carTloyal123/lochness/hardware/bom/devkit.csv

Category | Qty | Part | Manufacturer | MPN | Supplier | Supplier SKU | Unit USD | Extended USD | Required | In model | Price confirmed | URL | Notes
Bought | 1 | Espressif ESP32-C6-DevKitM-1 (the product's ESP32-C6-MINI-1 module), on its pin headers | Espressif | ESP32-C6-DEVKITM-1-N4 | DigiKey | 1965-ESP32-C6-DEVKITM-1-N4-ND | 8.00 | 8.00 | yes | yes | yes | https://www.digikey.com/en/products/detail/espressif-systems/ESP32-C6-DEVKITM-1-N4/18667011 | Headers appear fitted in photos; the user guide doesn't say.
Bought | 2 | Mini breadboard, 170 points (47 x 35 mm), adhesive back | SparkFun | PRT-12043 | SparkFun | PRT-12043 | 5.25 | 10.50 | yes | yes | yes | https://www.sparkfun.com/products/12043
Bought | 1 | NdFeB magnet 3 x 2 mm, axial (bolt position) | Apex Magnets | M3x2MMDI | Apex Magnets | M3x2MMDI | 0.18 | 0.18 | yes | yes | yes | https://www.apexmagnets.com/3mm-x-2mm-disc-neodymium-magnet | N48. Pack of 50 for $8.99.
Bought | 1 | Pololu #2130 DRV8833 dual motor driver carrier, on 2x 1x8 pin headers | Pololu | 2130 | Pololu | 2130 | 10.95 | 10.95 | yes | yes | yes | https://www.pololu.com/product/2130 | Headers included, unsoldered.
Bought | 1 | Pololu #5193 gearmotor, 150:1 HPCB 6 V, 12 CPR encoder, side connector (6-pin JST SH cable) | Pololu | 5193 | Pololu | 5193 | 32.45 | 32.45 | yes | yes | yes | https://www.pololu.com/product/5193 | Cable not included. $29.85 each at 5+.
Bought | 3 | SparkFun BOB-00717 SOT-23 adapter with a DRV5032FADBZR and 2x 1x3 header, worn chip-down | SparkFun | BOB-00717 | SparkFun | BOB-00717 | 1.25 | 3.75 | yes | yes | yes | https://www.sparkfun.com/products/717 | Adapter only: the chip and headers are separate lines. Page says 8.6 x 11.7 mm.
Bought | 3 | DRV5032FADBZR Hall switch, SOT-23 (soldered to the adapters) | Texas Instruments | DRV5032FADBZR | DigiKey | 296-47765-1-ND | 0.33 | 0.99 | yes | no | yes | https://www.digikey.com/en/products/detail/texas-instruments/DRV5032FADBZR/7400094
Bought | 1 | Break-away male headers, 40-pin, 0.1" (2x 1x3 per adapter) | SparkFun | PRT-00116 | SparkFun | PRT-00116 | 1.95 | 1.95 | yes | no | yes | https://www.sparkfun.com/products/116
Bought | 1 | Motor cable, 6-pin JST SH-style to bare wires, 12 cm (tinned ends into the breadboard) | Pololu | 4762 | Pololu | 4762 | 2.10 | 2.10 | yes | no | yes | https://www.pololu.com/product/4762 | Or a #4765 cable and a #4772 breakout ($1.49) for 0.1" pins.
Bought | 1 | Door-frame magnet for the door-position switch, NdFeB disc about 10 x 3 mm, axial, adhesive-backed | Apex Magnets |  | Apex Magnets |  | 0.50 | 0.50 | yes | no | estimate |  | Not chosen yet: size it for the door gap against the DRV5032FA's 3.9 mT. Price estimated.
Bought | 1 | USB-C cable, data (powers and programs the DevKit) | any |  |  |  | 5.00 | 5.00 | yes | no | estimate |  | Price estimated.
Cell | 4 | AA 1.5 V lithium cell (Energizer L91) | Energizer | L91 | Ace Hardware | L91SBP-8 | 3.37 | 13.48 | yes | yes | estimate |  | 8-pack about $27; US range $19-40.
Metal | 1 | Back plate, 3 mm steel, laser cut, 2x M3 tapped | SendCutSend | custom (0.119" mild steel, 2x M3 tap) | SendCutSend |  | 14.00 | 14.00 | yes | yes | estimate | https://sendcutsend.com | Estimate: $12-16 per part; order minimum about $29.
Metal | 1 | Battery contact, + flat with solder tab | Keystone | 5223 | DigiKey | 36-5223-ND | 0.17 | 0.17 | yes | yes | yes | https://www.digikey.com/en/products/detail/keystone-electronics/5223/316374 | Fits AA and CR123A.
Metal | 1 | Battery contact, - spring with solder tab | Keystone | 5201 | DigiKey | 36-5201-ND | 0.25 | 0.25 | yes | yes | yes | https://www.digikey.com/en/products/detail/keystone-electronics/5201/316365 | Fits AA and CR123A.
Metal | 3 | Battery link contact, + flat / - spring, nickel-plated steel | Keystone | 5212 | DigiKey | 36-5212-ND | 0.51 | 1.53 | yes | yes | yes | https://www.digikey.com/en/products/detail/keystone-electronics/5212/316371 | AA dual contact for cells in series.
Fastener | 2 | Deadbolt through-screw, flat head (thread per brand, e.g. #8-32 x 1") | (deadbolt maker) |  | reused |  | 0.00 | 0.00 | yes | yes | yes |  | Comes with the deadbolt; longer ones per brand if needed.
Fastener | 15 | Heat-set insert M2 x 3 (hole 3.2 mm) | CNC Kitchen | Threaded Inserts M2 Standard | 3DJake |  | 0.11 | 1.67 | yes | yes | yes | https://www.3djake.com/cnc-kitchen/threaded-inserts-m2-standard | Pack of 100 for $11.12, ships from the EU.
Fastener | 3 | Heat-set insert M3 x 5.7 (hole 4 mm) | CNC Kitchen | Heat Set Inserts M3 standard | Prusa |  | 0.11 | 0.33 | yes | yes | yes | https://www.prusa3d.com/en/product/heat-set-inserts-m3-standard-100-pcs/ | Pack of 100 for $10.99.
Fastener | 2 | M1.6 x 3 pan head (ISO 7045) | Pololu | 1954 | Pololu | 1954 | 0.62 | 1.24 | yes | yes | yes | https://www.pololu.com/product/1954 | Pack of 6 for $3.71.
Fastener | 4 | M2 x 16 button head hex socket | McMaster-Carr | 92095A111 | McMaster-Carr | 92095A111 | 0.11 | 0.44 | yes | yes | estimate | https://www.mcmaster.com/92095A111 | 18-8 stainless; pack of 100, per-piece price estimated. ISO 7380.
Fastener | 3 | M2 x 20 button head hex socket | McMaster-Carr | 92095A106 | McMaster-Carr | 92095A106 | 0.12 | 0.36 | yes | yes | estimate | https://www.mcmaster.com/92095A106 | 18-8 stainless; pack of 100, per-piece price estimated. ISO 7380.
Fastener | 2 | M2 x 6 button head hex socket | McMaster-Carr | 92095A453 | McMaster-Carr | 92095A453 | 0.10 | 0.20 | yes | yes | estimate | https://www.mcmaster.com/92095A453 | 18-8 stainless; pack of 100, per-piece price estimated. ISO 7380.
Fastener | 6 | M2 x 8 button head hex socket | McMaster-Carr | 92095A454 | McMaster-Carr | 92095A454 | 0.10 | 0.60 | yes | yes | estimate | https://www.mcmaster.com/92095A454 | 18-8 stainless; pack of 100, per-piece price estimated. ISO 7380.
Fastener | 2 | M3 x 5 button head hex socket (ISO 7380) | McMaster-Carr | 92095A177 | McMaster-Carr | 92095A177 | 0.07 | 0.14 | yes | yes | estimate | https://www.mcmaster.com/92095A177 | 18-8 stainless; pack of 100, per-piece price estimated.
Fastener | 2 | M3 x 6 countersunk hex socket (ISO 10642) | McMaster-Carr | 92125A126 | McMaster-Carr | 92125A126 | 0.08 | 0.16 | yes | yes | estimate | https://www.mcmaster.com/92125A126 | 18-8 stainless; pack of 100, per-piece price estimated.
Fastener | 1 | M3 x 8 button head hex socket (ISO 7380) | McMaster-Carr | 92095A181 | McMaster-Carr | 92095A181 | 0.08 | 0.08 | yes | yes | estimate | https://www.mcmaster.com/92095A181 | 18-8 stainless; pack of 100, per-piece price estimated.
Printed | 1 | Bolt flag (magnet carrier) on the coupler's D-shaft | printed |  |  |  | 0.04 | 0.04 | yes | yes | yes |  | Filament, 1.5 cm3 solid each (PETG 1.27 g/cm3 at $20/kg).
Printed | 4 | Breadboard clamp bar, PETG | printed |  |  |  | 0.06 | 0.22 | yes | yes | yes |  | Filament, 2.2 cm3 solid each (PETG 1.27 g/cm3 at $20/kg).
Printed | 1 | Breadboard deck (in place of the main PCB), PETG | printed |  |  |  | 0.57 | 0.57 | yes | yes | yes |  | Filament, 22.3 cm3 solid each (PETG 1.27 g/cm3 at $20/kg).
Printed | 1 | Bridge: gear retainer, motor mount | printed |  |  |  | 0.29 | 0.29 | yes | yes | yes |  | Filament, 11.6 cm3 solid each (PETG 1.27 g/cm3 at $20/kg).
Printed | 3 | Carrier spacer tube, 5 mm OD | printed |  |  |  | 0.00 | 0.01 | yes | yes | yes |  | Filament, 0.2 cm3 solid each (PETG 1.27 g/cm3 at $20/kg).
Printed | 1 | Chassis tray (slab, 17 mm taller), PETG/ASA | printed |  |  |  | 1.35 | 1.35 | yes | yes | yes |  | Filament, 53.1 cm3 solid each (PETG 1.27 g/cm3 at $20/kg).
Printed | 1 | Coupler / tailpiece adapter (per brand), PA12 or PETG-CF | printed |  |  |  | 0.17 | 0.17 | yes | yes | yes |  | Filament, 6.6 cm3 solid each (PETG 1.27 g/cm3 at $20/kg).
Printed | 2 | Deck spacer tube, 5 mm OD | printed |  |  |  | 0.00 | 0.00 | yes | yes | yes |  | Filament, 0.1 cm3 solid each (PETG 1.27 g/cm3 at $20/kg).
Printed | 1 | Hall carrier: holds the three adapters chip-down (glued in its slots), PETG | printed |  |  |  | 0.07 | 0.07 | yes | yes | yes |  | Filament, 2.6 cm3 solid each (PETG 1.27 g/cm3 at $20/kg).
Printed | 1 | Manual knob, PETG/ASA | printed |  |  |  | 0.36 | 0.36 | yes | yes | yes |  | Filament, 14.3 cm3 solid each (PETG 1.27 g/cm3 at $20/kg).
Printed | 1 | Motor pinion, m1 10T (or brass, pressed) | printed |  |  |  | 0.01 | 0.01 | yes | yes | yes |  | Filament, 0.4 cm3 solid each (PETG 1.27 g/cm3 at $20/kg).
Printed | 1 | Open cover with a front window and USB slot, PETG (clear works) | printed |  |  |  | 1.37 | 1.37 | yes | yes | yes |  | Filament, 53.9 cm3 solid each (PETG 1.27 g/cm3 at $20/kg).
Printed | 1 | Output gear, m1 40T, lost-motion pocket 132 deg | printed |  |  |  | 0.13 | 0.13 | yes | yes | yes |  | Filament, 5.3 cm3 solid each (PETG 1.27 g/cm3 at $20/kg).
Wire | 1 | Jumper wire, black: GND row to the DRV8833 GND | kit |  |  |  | 0.00 | 0.00 | yes | yes | yes |  | From the jumper wire kit.
Wire | 1 | Jumper wire, black: J3 GND to the GND row | kit |  |  |  | 0.00 | 0.00 | yes | yes | yes |  | From the jumper wire kit.
Wire | 1 | Jumper wire, black: battery - to the DRV8833 GND | kit |  |  |  | 0.00 | 0.00 | yes | yes | yes |  | From the jumper wire kit.
Wire | 1 | Jumper wire, black: hall_door GND | kit |  |  |  | 0.00 | 0.00 | yes | yes | yes |  | From the jumper wire kit.
Wire | 1 | Jumper wire, black: hall_locked GND | kit |  |  |  | 0.00 | 0.00 | yes | yes | yes |  | From the jumper wire kit.
Wire | 1 | Jumper wire, black: hall_unlocked GND | kit |  |  |  | 0.00 | 0.00 | yes | yes | yes |  | From the jumper wire kit.
Wire | 1 | Jumper wire, black: motor cable pin 1, encoder GND | kit |  |  |  | 0.00 | 0.00 | yes | yes | yes |  | From the jumper wire kit.
Wire | 1 | Jumper wire, black: motor cable pin 5, M2 | kit |  |  |  | 0.00 | 0.00 | yes | yes | yes |  | From the jumper wire kit.
Wire | 1 | Jumper wire, blue: hall_door OUT | kit |  |  |  | 0.00 | 0.00 | yes | yes | yes |  | From the jumper wire kit.
Wire | 1 | Jumper wire, blue: hall_locked OUT | kit |  |  |  | 0.00 | 0.00 | yes | yes | yes |  | From the jumper wire kit.
Wire | 1 | Jumper wire, blue: hall_unlocked OUT | kit |  |  |  | 0.00 | 0.00 | yes | yes | yes |  | From the jumper wire kit.
Wire | 1 | Jumper wire, green: motor cable pin 2, encoder B | kit |  |  |  | 0.00 | 0.00 | yes | yes | yes |  | From the jumper wire kit.
Wire | 1 | Jumper wire, orange: GPIO 19 to DRV8833 AIN2 | kit |  |  |  | 0.00 | 0.00 | yes | yes | yes |  | From the jumper wire kit.
Wire | 1 | Jumper wire, purple: GPIO 3 to DRV8833 nFAULT | kit |  |  |  | 0.00 | 0.00 | yes | yes | yes |  | From the jumper wire kit.
Wire | 1 | Jumper wire, red: 3V3 to the 3V3 row | kit |  |  |  | 0.00 | 0.00 | yes | yes | yes |  | From the jumper wire kit.
Wire | 1 | Jumper wire, red: battery + to the DRV8833 VIN | kit |  |  |  | 0.00 | 0.00 | yes | yes | yes |  | From the jumper wire kit.
Wire | 1 | Jumper wire, red: hall_door VCC | kit |  |  |  | 0.00 | 0.00 | yes | yes | yes |  | From the jumper wire kit.
Wire | 1 | Jumper wire, red: hall_locked VCC | kit |  |  |  | 0.00 | 0.00 | yes | yes | yes |  | From the jumper wire kit.
Wire | 1 | Jumper wire, red: hall_unlocked VCC | kit |  |  |  | 0.00 | 0.00 | yes | yes | yes |  | From the jumper wire kit.
Wire | 1 | Jumper wire, red: motor cable pin 4, encoder VCC | kit |  |  |  | 0.00 | 0.00 | yes | yes | yes |  | From the jumper wire kit.
Wire | 1 | Jumper wire, red: motor cable pin 6, M1 | kit |  |  |  | 0.00 | 0.00 | yes | yes | yes |  | From the jumper wire kit.
Wire | 1 | Jumper wire, white: GPIO 20 to DRV8833 nSLEEP | kit |  |  |  | 0.00 | 0.00 | yes | yes | yes |  | From the jumper wire kit.
Wire | 1 | Jumper wire, yellow: GPIO 18 to DRV8833 AIN1 | kit |  |  |  | 0.00 | 0.00 | yes | yes | yes |  | From the jumper wire kit.
Wire | 1 | Jumper wire, yellow: motor cable pin 3, encoder A | kit |  |  |  | 0.00 | 0.00 | yes | yes | yes |  | From the jumper wire kit.
Wire | 1 | Jumper wire kit, 22 AWG solid, pre-bent, 140 pieces (covers the jumper wires) | SparkFun | PRT-00124 | SparkFun | PRT-00124 | 8.95 | 8.95 | yes | no | yes | https://www.sparkfun.com/products/124
Wire | 1 | Hookup wire, 26 AWG silicone, 2 m (battery contacts to the breadboard) | Adafruit | 1881 | Adafruit | 1881 | 0.95 | 0.95 | yes | no | yes | https://www.adafruit.com/product/1881
Total |  | Required parts |  |  |  |  |  | 125.51
