carTloyal123/lochness/hardware/bom/A-puck.csv

Category | Qty | Part | Manufacturer | MPN | Supplier | Supplier SKU | Unit USD | Extended USD | Required | In model | Price confirmed | URL | Notes
PCB | 1 | Bolt-sensor board, 2x Hall switch, wired to the main PCB | custom |  | PCB fab + assembly |  | 3.16 | 3.16 | yes | yes | estimate |  | Priced as two Hall adapters with chips.
PCB | 1 | Main PCB, annular, 1.6 mm FR4 (chip-down ESP32-C6) | custom |  | PCB fab + assembly |  | 22.48 | 22.48 | yes | yes | estimate |  | Assembled. Priced as the dev boards it replaces (DevKitM-1 + Pololu 2130 + 3 Hall adapters with chips and headers) = $25.64. Less the two bolt Hall sets, which are on the sensor board.
Bought | 1 | 2.4 GHz chip antenna | Johanson Technology | 2450AT18A0100001E | DigiKey | 712-2450AT18A0100001ECT-ND | 0.00 | 0.00 | yes | yes | yes | https://www.digikey.com/en/products/detail/johanson-technology-inc/2450AT18A100E/1560676 | On the PCB; cost in the PCB line ($0.51 each loose). Formerly 2450AT18A100E.
Bought | 2 | Battery connector | JST | S2B-PH-K-S | DigiKey | 455-1719-ND | 0.00 | 0.00 | yes | yes | yes | https://www.digikey.com/en/products/detail/jst-sales-america-inc/S2B-PH-K-S/926626 | On the PCB; cost in the PCB line ($0.10 each loose). 2-pin PH, right angle.
Bought | 1 | DRV5032FADBZR Hall switch, SOT-23: bolt locked (underside) | Texas Instruments | DRV5032FADBZR | DigiKey | 296-47765-1-ND | 0.00 | 0.00 | yes | yes | yes | https://www.digikey.com/en/products/detail/texas-instruments/DRV5032FADBZR/7400094 | On the PCB; cost in the PCB line ($0.33 each loose).
Bought | 1 | DRV5032FADBZR Hall switch, SOT-23: bolt unlocked (underside) | Texas Instruments | DRV5032FADBZR | DigiKey | 296-47765-1-ND | 0.00 | 0.00 | yes | yes | yes | https://www.digikey.com/en/products/detail/texas-instruments/DRV5032FADBZR/7400094 | On the PCB; cost in the PCB line ($0.33 each loose).
Bought | 1 | DRV5032FADBZR Hall switch, SOT-23: door position (magnet on the frame) | Texas Instruments | DRV5032FADBZR | DigiKey | 296-47765-1-ND | 0.00 | 0.00 | yes | yes | yes | https://www.digikey.com/en/products/detail/texas-instruments/DRV5032FADBZR/7400094 | On the PCB; cost in the PCB line ($0.33 each loose).
Bought | 1 | DRV8833PWPR dual H-bridge, HTSSOP-16 | Texas Instruments | DRV8833PWPR | DigiKey | 296-29434-1-ND | 0.00 | 0.00 | yes | yes | yes | https://www.digikey.com/en/products/detail/texas-instruments/DRV8833PWPR/2743167 | On the PCB; cost in the PCB line ($2.68 each loose).
Bought | 1 | ESP32-C6 QFN40 5 x 5 (chip-down: the same chip as the MINI-1 module) | Espressif | ESP32-C6FH4 | DigiKey | 1904-ESP32-C6FH4CT-ND | 0.00 | 0.00 | yes | yes | yes | https://www.digikey.com/en/products/detail/espressif-systems/ESP32-C6FH4/18587545 | On the PCB; cost in the PCB line ($2.06 each loose). 4 MB flash in the package.
Bought | 1 | JST SM06B-SRSS-TB, 6-pin SH side entry (motor + encoder cable) | JST | SM06B-SRSS-TB | DigiKey | 455-SM06B-SRSS-TBCT-ND | 0.00 | 0.00 | yes | yes | yes | https://www.digikey.com/en/products/detail/jst-sales-america-inc/SM06B-SRSS-TB/926712 | On the PCB; cost in the PCB line ($0.67 each loose).
Bought | 1 | NdFeB magnet 3 x 2 mm, axial (bolt position) | Apex Magnets | M3x2MMDI | Apex Magnets | M3x2MMDI | 0.18 | 0.18 | yes | yes | yes | https://www.apexmagnets.com/3mm-x-2mm-disc-neodymium-magnet | N48. Pack of 50 for $8.99.
Bought | 1 | Pololu #5193 gearmotor, 150:1 HPCB 6 V, 12 CPR encoder, side connector (6-pin JST SH cable) | Pololu | 5193 | Pololu | 5193 | 32.45 | 32.45 | yes | yes | yes | https://www.pololu.com/product/5193 | Cable not included. $29.85 each at 5+.
Bought | 1 | Status RGB LED | Kingbright | APTF1616SEEZGKQBKC | DigiKey | 754-1977-1-ND | 0.00 | 0.00 | yes | yes | yes | https://www.digikey.com/en/products/detail/kingbright/APTF1616SEEZGKQBKC/5803669 | On the PCB; cost in the PCB line ($0.92 each loose). 1.6 x 1.6 mm.
Bought | 1 | TPS629206DRLR 3.3 V buck, SOT-583 (3-17 V in, 4 uA) | Texas Instruments | TPS629206DRLR | DigiKey | 296-TPS629206DRLRCT-ND | 0.00 | 0.00 | yes | yes | yes | https://www.digikey.com/en/products/detail/texas-instruments/TPS629206DRLR/16516686 | On the PCB; cost in the PCB line ($1.08 each loose).
Bought | 1 | Motor cable, 6-pin JST SH-style both ends, 10 cm | Pololu | 4765 | Pololu | 4765 | 3.32 | 3.32 | yes | no | yes | https://www.pololu.com/product/4765 | Check the fit on a genuine JST SM06B-SRSS-TB. 16 cm is #4766 ($3.61).
Bought | 1 | Door-frame magnet for the door-position switch, NdFeB disc about 10 x 3 mm, axial, adhesive-backed | Apex Magnets |  | Apex Magnets |  | 0.50 | 0.50 | yes | no | estimate |  | Not chosen yet: size it for the door gap against the DRV5032FA's 3.9 mT. Price estimated.
Bought | 1 | Passives: decoupling, buck inductor and caps, pull-ups, ESD (per schematic, not yet designed) | various |  |  |  | 0.00 | 0.00 | yes | no | yes |  | On the PCB; cost in the PCB line ($0.00 each loose). In the PCB line.
Bought | 1 | 40 MHz crystal for the chip-down ESP32-C6 (per schematic) | various |  |  |  | 0.00 | 0.00 | yes | no | yes |  | On the PCB; cost in the PCB line ($0.00 each loose). In the PCB line.
Cell | 2 | CR123A 3 V lithium cell | Energizer | EL123AP | Home Depot | EL123APB2 | 4.80 | 9.60 | yes | yes | estimate |  | 2-pack about $9.59.
Metal | 1 | Back plate, 3 mm steel, laser cut, 2x M3 tapped | SendCutSend | custom (0.119" mild steel, 2x M3 tap) | SendCutSend |  | 14.00 | 14.00 | yes | yes | estimate | https://sendcutsend.com | Estimate: $12-16 per part; order minimum about $29.
Metal | 2 | Battery contact, + flat with solder tab | Keystone | 5223 | DigiKey | 36-5223-ND | 0.17 | 0.34 | yes | yes | yes | https://www.digikey.com/en/products/detail/keystone-electronics/5223/316374 | Fits AA and CR123A.
Metal | 2 | Battery contact, - spring with solder tab | Keystone | 5201 | DigiKey | 36-5201-ND | 0.25 | 0.50 | yes | yes | yes | https://www.digikey.com/en/products/detail/keystone-electronics/5201/316365 | Fits AA and CR123A.
Fastener | 2 | Deadbolt through-screw, flat head (thread per brand, e.g. #8-32 x 1") | (deadbolt maker) |  | reused |  | 0.00 | 0.00 | yes | yes | yes |  | Comes with the deadbolt; longer ones per brand if needed.
Fastener | 4 | Heat-set insert M2 x 3 (hole 3.2 mm) | CNC Kitchen | Threaded Inserts M2 Standard | 3DJake |  | 0.11 | 0.44 | yes | yes | yes | https://www.3djake.com/cnc-kitchen/threaded-inserts-m2-standard | Pack of 100 for $11.12, ships from the EU.
Fastener | 1 | Heat-set insert M3 x 5.7 (hole 4 mm) | CNC Kitchen | Heat Set Inserts M3 standard | Prusa |  | 0.11 | 0.11 | yes | yes | yes | https://www.prusa3d.com/en/product/heat-set-inserts-m3-standard-100-pcs/ | Pack of 100 for $10.99.
Fastener | 2 | M1.6 x 3 pan head (ISO 7045) | Pololu | 1954 | Pololu | 1954 | 0.62 | 1.24 | yes | yes | yes | https://www.pololu.com/product/1954 | Pack of 6 for $3.71.
Fastener | 2 | M2 x 16 button head hex socket | McMaster-Carr | 92095A111 | McMaster-Carr | 92095A111 | 0.11 | 0.22 | yes | yes | estimate | https://www.mcmaster.com/92095A111 | 18-8 stainless; pack of 100, per-piece price estimated. ISO 7380.
Fastener | 2 | M2 x 6 button head hex socket | McMaster-Carr | 92095A453 | McMaster-Carr | 92095A453 | 0.10 | 0.20 | yes | yes | estimate | https://www.mcmaster.com/92095A453 | 18-8 stainless; pack of 100, per-piece price estimated. ISO 7380.
Fastener | 2 | M3 x 5 button head hex socket (ISO 7380) | McMaster-Carr | 92095A177 | McMaster-Carr | 92095A177 | 0.07 | 0.14 | yes | yes | estimate | https://www.mcmaster.com/92095A177 | 18-8 stainless; pack of 100, per-piece price estimated.
Fastener | 1 | M3 x 6 button head hex socket (ISO 7380) | McMaster-Carr | 92095A179 | McMaster-Carr | 92095A179 | 0.07 | 0.07 | yes | yes | estimate | https://www.mcmaster.com/92095A179 | 18-8 stainless; pack of 100, per-piece price estimated. Part number confirmed.
Printed | 1 | Bolt flag (magnet carrier) on the coupler's D-shaft | printed |  |  |  | 0.02 | 0.02 | yes | yes | yes |  | Filament, 0.9 cm3 solid each (PETG 1.27 g/cm3 at $20/kg).
Printed | 1 | Bridge: gear retainer, motor mount, PCB clamp, cell holder | printed |  |  |  | 0.34 | 0.34 | yes | yes | yes |  | Filament, 13.3 cm3 solid each (PETG 1.27 g/cm3 at $20/kg).
Printed | 1 | Chassis cup (the visible body), PETG/ASA | printed |  |  |  | 0.84 | 0.84 | yes | yes | yes |  | Filament, 33.1 cm3 solid each (PETG 1.27 g/cm3 at $20/kg).
Printed | 1 | Coupler / tailpiece adapter (per brand), PA12 or PETG-CF | printed |  |  |  | 0.16 | 0.16 | yes | yes | yes |  | Filament, 6.3 cm3 solid each (PETG 1.27 g/cm3 at $20/kg).
Printed | 1 | Front cap = manual knob, PETG/ASA | printed |  |  |  | 1.07 | 1.07 | yes | yes | yes |  | Filament, 42.3 cm3 solid each (PETG 1.27 g/cm3 at $20/kg).
Printed | 1 | Light pipe, clear PMMA/PC, 3 mm, through the cup wall | printed |  |  |  | 0.00 | 0.00 | yes | yes | yes |  | Filament, 0.0 cm3 solid each (PETG 1.27 g/cm3 at $20/kg).
Printed | 1 | Motor pinion, m1 10T (or brass, pressed) | printed |  |  |  | 0.01 | 0.01 | yes | yes | yes |  | Filament, 0.4 cm3 solid each (PETG 1.27 g/cm3 at $20/kg).
Printed | 1 | Output gear, m1 40T, lost-motion pocket 132 deg | printed |  |  |  | 0.13 | 0.13 | yes | yes | yes |  | Filament, 5.3 cm3 solid each (PETG 1.27 g/cm3 at $20/kg).
Printed | 2 | PCB spacer tube, 5 mm OD | printed |  |  |  | 0.00 | 0.01 | yes | yes | yes |  | Filament, 0.1 cm3 solid each (PETG 1.27 g/cm3 at $20/kg).
Wire | 2 | Battery lead, JST PH 2-pin female, 100 mm (soldered to the end contacts) | Adafruit | 261 | Adafruit | 261 | 0.75 | 1.50 | yes | no | yes | https://www.adafruit.com/product/261
Wire | 1 | Hookup wire, 26 AWG silicone, 2 m (sensor board to main PCB) | Adafruit | 1881 | Adafruit | 1881 | 0.95 | 0.95 | yes | no | yes | https://www.adafruit.com/product/1881
Total |  | Required parts |  |  |  |  |  | 93.98
