carTloyal123/lochness/hardware/pcb/main/lochness-main.kicad_sch

## KiCad design hardware/pcb/main/lochness-main.kicad_sch (2026-11-12)

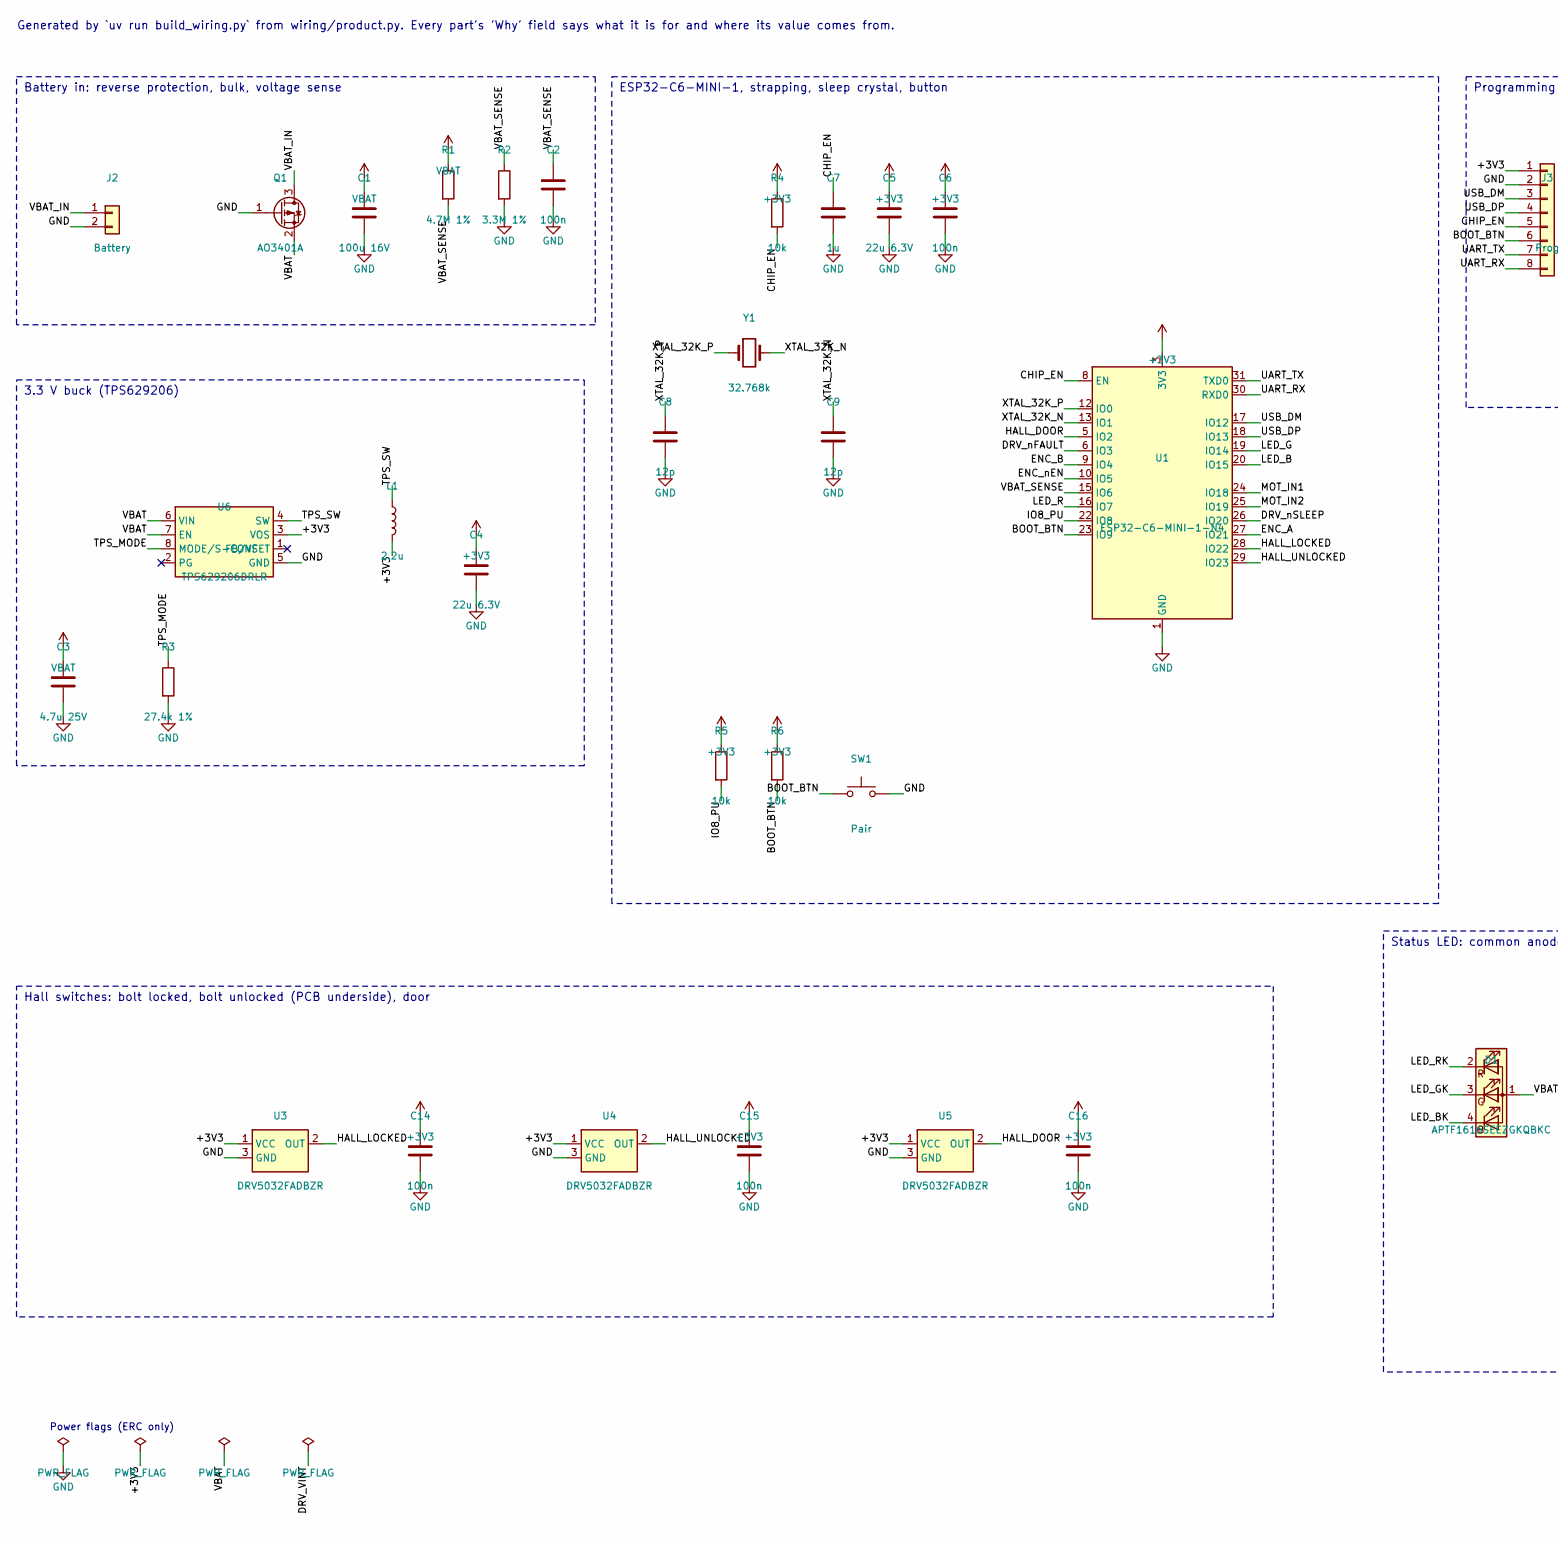
[picture p3: schematic lochness-main.kicad_sch, part in row 1, column 1]

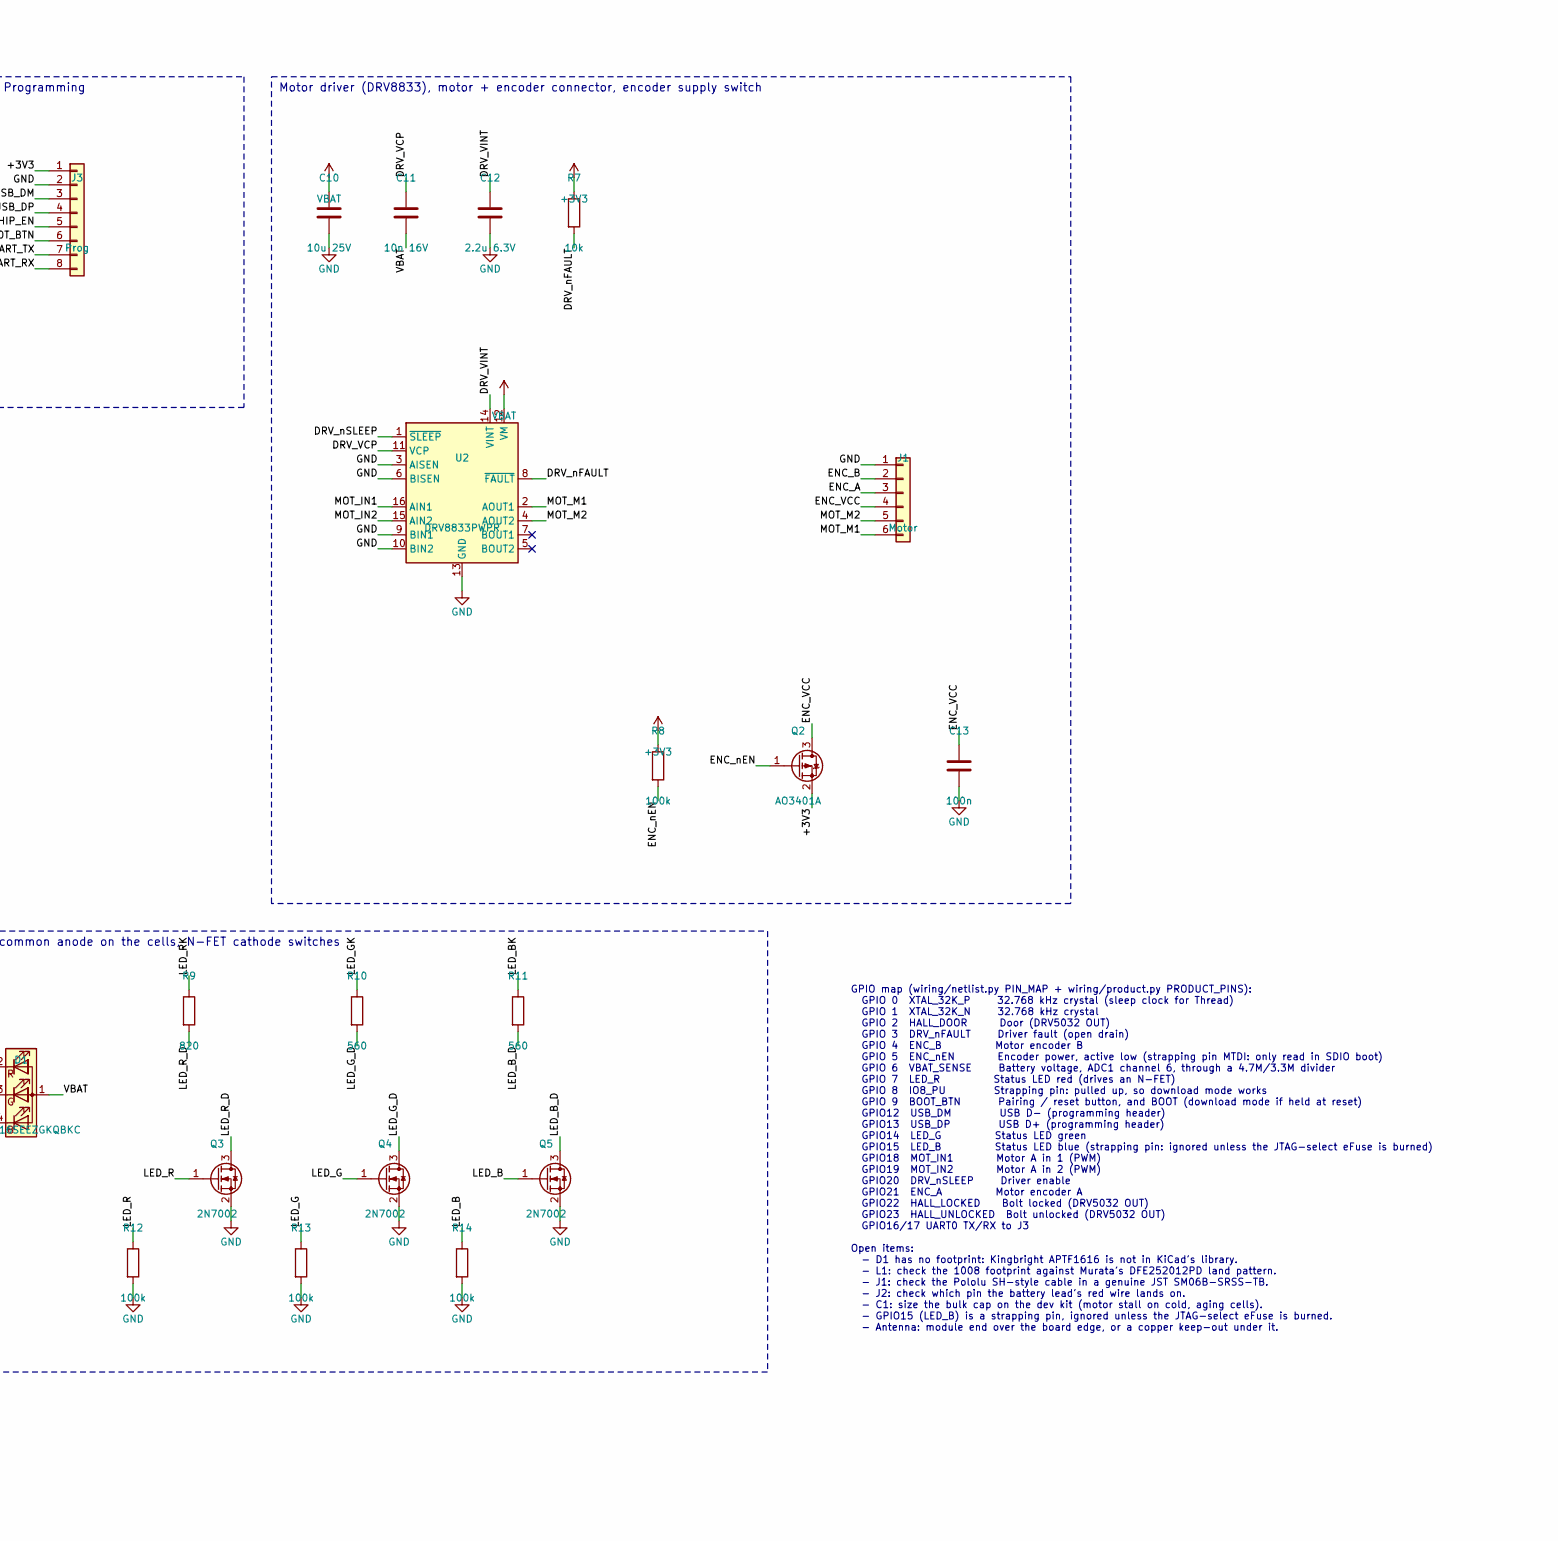
[picture p4: schematic lochness-main.kicad_sch, part in row 1, column 2]

Parts:
C1: 100u 16V; C_1206_3216Metric; MPN EEE-FT1C101AR
C2, C6, C13, C14, C15, C16: 100n; C_0402_1005Metric
C3: 4.7u 25V; C_1206_3216Metric; MPN C3216X7R1E475K160AC
C4, C5: 22u 6.3V; C_0805_2012Metric; MPN GCM21BD70J226ME36L
C7: 1u; C_0402_1005Metric
C8, C9: 12p; C_0402_1005Metric
C10: 10u 25V; C_1206_3216Metric
C11: 10n 16V; C_0402_1005Metric
C12: 2.2u 6.3V; C_0402_1005Metric
D1: APTF1616SEEZGKQBKC; MPN APTF1616SEEZGKQBKC
J1: Motor; JST_SH_SM06B-SRSS-TB_1x06-1MP_P1.00mm_Horizontal; MPN SM06B-SRSS-TB
J2: Battery; JST_PH_S2B-PH-K_1x02_P2.00mm_Horizontal; MPN S2B-PH-K-S
J3: Prog; PinHeader_1x08_P1.27mm_Vertical
L1: 2.2u; L_1008_2520Metric; MPN DFE252012PD-2R2M#
Q1, Q2: AO3401A; SOT-23; MPN AO3401A
Q3, Q4, Q5: 2N7002; SOT-23; MPN 2N7002
R1: 4.7M 1%; R_0402_1005Metric
R2: 3.3M 1%; R_0402_1005Metric
R3: 27.4k 1%; R_0402_1005Metric
R4, R5, R6, R7: 10k; R_0402_1005Metric
R8, R12, R13, R14: 100k; R_0402_1005Metric
R9: 820; R_0402_1005Metric
R10, R11: 560; R_0402_1005Metric
SW1: Pair; SW_SPST_PTS810; MPN PTS810SJM250SMTR LFS
U1: ESP32-C6-MINI-1-N4; ESP32-C6-MINI-1; MPN ESP32-C6-MINI-1-N4
U2: DRV8833PWPR; HTSSOP-16-1EP_4.4x5mm_P0.65mm_EP3.4x5mm_Mask2.46x2.31mm_The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; MPN DRV8833PWPR
U3, U4, U5: DRV5032FADBZR; SOT-23; MPN DRV5032FADBZR
U6: TPS629206DRLR; SOT-583-8; MPN TPS629206DRLR
Y1: 32.768k; Crystal_SMD_3215-2Pin_3.2x1.5mm; MPN ABS07-32.768KHZ-7-T

Connections:
+3V3: C4.1, C5.1, C6.1, C14.1, C15.1, C16.1, J3.1, L1.2, Q2.2 (S), R4.1, R5.1, R6.1, R7.1, R8.1, U1.3 (3V3), U3.1 (VCC), U4.1 (VCC), U5.1 (VCC), U6.3 (VOS)
BOOT_BTN: J3.6, R6.2, SW1.1, U1.23 (IO9)
CHIP_EN: C7.1, J3.5, R4.2, U1.8 (EN)
DRV_VCP: C11.1, U2.11 (VCP)
DRV_VINT: C12.1, U2.14 (VINT)
DRV_nFAULT: R7.2, U1.6 (IO3), U2.8 (~FAULT)
DRV_nSLEEP: U1.26 (IO20), U2.1 (~SLEEP)
ENC_A: J1.3, U1.27 (IO21)
ENC_B: J1.2, U1.9 (IO4)
ENC_VCC: C13.1, J1.4, Q2.3 (D)
ENC_nEN: Q2.1 (G), R8.2, U1.10 (IO5)
GND: C1.2, C2.2, C3.2, C4.2, C5.2, C6.2, C7.2, C8.2, C9.2, C10.2, C12.2, C13.2, C14.2, C15.2, C16.2, J1.1, J2.2, J3.2, Q1.1 (G), Q3.2 (S), Q4.2 (S), Q5.2 (S), R2.2, R3.2, R12.2, R13.2, R14.2, SW1.2, U1.1 (GND), U1.2 (GND), U1.11 (GND), U1.14 (GND), U1.36 (GND), U1.37 (GND), U1.38 (GND), U1.39 (GND), U1.40 (GND), U1.41 (GND), U1.42 (GND), U1.43 (GND), U1.44 (GND), U1.45 (GND), U1.46 (GND), U1.47 (GND), U1.48 (GND), U1.49 (GND), U1.50 (GND), U1.51 (GND), U1.52 (GND), U1.53 (GND), U2.3 (AISEN), U2.6 (BISEN), U2.9 (BIN1), U2.10 (BIN2), U2.13 (GND), U2.17 (GND), U3.3 (GND), U4.3 (GND), U5.3 (GND), U6.5 (GND)
HALL_DOOR: U1.5 (IO2), U5.2 (OUT)
HALL_LOCKED: U1.28 (IO22), U3.2 (OUT)
HALL_UNLOCKED: U1.29 (IO23), U4.2 (OUT)
IO8_PU: R5.2, U1.22 (IO8)
LED_B: Q5.1 (G), R14.1, U1.20 (IO15)
LED_BK: D1.4 (BK), R11.1
LED_B_D: Q5.3 (D), R11.2
LED_G: Q4.1 (G), R13.1, U1.19 (IO14)
LED_GK: D1.3 (GK), R10.1
LED_G_D: Q4.3 (D), R10.2
LED_R: Q3.1 (G), R12.1, U1.16 (IO7)
LED_RK: D1.2 (RK), R9.1
LED_R_D: Q3.3 (D), R9.2
MOT_IN1: U1.24 (IO18), U2.16 (AIN1)
MOT_IN2: U1.25 (IO19), U2.15 (AIN2)
MOT_M1: J1.6, U2.2 (AOUT1)
MOT_M2: J1.5, U2.4 (AOUT2)
TPS_MODE: R3.1, U6.8 (MODE/S-CONF)
TPS_SW: L1.1, U6.4 (SW)
UART_RX: J3.8, U1.30 (RXD0)
UART_TX: J3.7, U1.31 (TXD0)
USB_DM: J3.3, U1.17 (IO12)
USB_DP: J3.4, U1.18 (IO13)
VBAT: C1.1, C3.1, C10.1, C11.2, D1.1 (A), Q1.2 (S), R1.1, U2.12 (VM), U6.6 (VIN), U6.7 (EN)
VBAT_IN: J2.1, Q1.3 (D)
VBAT_SENSE: C2.1, R1.2, R2.1, U1.15 (IO6)
XTAL_32K_N: C9.1, U1.13 (IO1), Y1.2
XTAL_32K_P: C8.1, U1.12 (IO0), Y1.1

Notes on the sheet:
ESP32-C6-MINI-1, strapping, sleep crystal, button
Status LED: common anode on the cells, N-FET cathode switches
Power flags (ERC only)
Motor driver (DRV8833), motor + encoder connector, encoder supply switch
GPIO map (wiring/netlist.py PIN_MAP + wiring/product.py PRODUCT_PINS): GPIO 0 XTAL_32K_P 32.768 kHz crystal (sleep clock for Thread) GPIO 1 XTAL_32K_N 32.768 kHz crystal GPIO 2 HALL_DOOR Door (DRV5032 OUT) GPIO 3 DRV_nFAULT Driver fault (open drain) GPIO 4 ENC_B Motor encoder B GPIO 5 ENC_nEN Encod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
Battery in: reverse protection, bulk, voltage sense
3.3 V buck (TPS629206)
Programming
Hall switches: bolt locked, bolt unlocked (PCB underside), door
Generated by `uv run build_wiring.py` from wiring/product.py. Every part's 'Why' field says what it is for and where its value comes from.
