carTloyal123/lochness/firmware/apps/keypad/main/input.c

#include "input.h"

#include "driver/gpio.h"
#include "esp_log.h"
#include "freertos/FreeRTOS.h"
#include "freertos/task.h"
#include "keypad_task.h"
#include "sdkconfig.h"
#include <stdint.h>

static const char *const TAG = "input";

enum {
    SCAN_MS = 10,
    DEBOUNCE_SCANS = 3, /* 30 ms stable before a press counts */
    PAIR_HOLD_MS = 3000,
    ROW_COUNT = 4,
    COL_COUNT = 3,
    ROW_SETTLE_US = 5,
    INPUT_TASK_STACK = 3072,
    INPUT_TASK_PRIO = 6,
};

#if CONFIG_KEYPAD_MATRIX
static const gpio_num_t ROWS[ROW_COUNT] = {CONFIG_KEYPAD_ROW0_GPIO, CONFIG_KEYPAD_ROW1_GPIO, CONFIG_KEYPAD_ROW2_GPIO,
                                   CONFIG_KEYPAD_ROW3_GPIO};
static const gpio_num_t COLS[COL_COUNT] = {CONFIG_KEYPAD_COL0_GPIO, CONFIG_KEYPAD_COL1_GPIO, CONFIG_KEYPAD_COL2_GPIO};
static const char LAYOUT[ROW_COUNT][COL_COUNT] = {{'1', '2', '3'}, {'4', '5', '6'}, {'7', '8', '9'}, {'*', '0', '#'}};
#endif

typedef struct {
    uint8_t stable_count;
    bool pressed;
} debounce_t;

/* Returns true on a debounced press edge. */
static bool debounce(debounce_t *d, bool raw)
{
    if (raw == d->pressed) {
        d->stable_count = 0;
        return false;
    }
    if (++d->stable_count < DEBOUNCE_SCANS) {
        return false;
    }
    d->stable_count = 0;
    d->pressed = raw;
    return raw;
}

static void input_pin(gpio_num_t pin)
{
    gpio_config_t cfg = {
        .pin_bit_mask = 1ULL << (unsigned)pin, .mode = GPIO_MODE_INPUT, .pull_up_en = GPIO_PULLUP_ENABLE};
    ESP_ERROR_CHECK(gpio_config(&cfg));
}

static void input_task(void *arg)
{
    (void)arg;
#if CONFIG_KEYPAD_MATRIX
    static debounce_t keys[ROW_COUNT][COL_COUNT];
#endif
#if CONFIG_KEYPAD_LOCK_BUTTON_GPIO >= 0
    static debounce_t lock_btn;
#endif
#if CONFIG_KEYPAD_PAIR_BUTTON_GPIO >= 0
    static debounce_t pair_btn;
    uint32_t pair_held_ms = 0;
    bool pair_fired = false;
#endif
    /* TODO(power): replace polling with GPIO wake from light/deep sleep. */
    for (;;) {
#if CONFIG_KEYPAD_MATRIX
        for (int r = 0; r < ROW_COUNT; r++) {
            gpio_set_level(ROWS[r], 0);
            esp_rom_delay_us(ROW_SETTLE_US);
            for (int c = 0; c < COL_COUNT; c++) {
                if (debounce(&keys[r][c], gpio_get_level(COLS[c]) == 0)) {
                    keypad_task_post_key(LAYOUT[r][c]);
                }
            }
            gpio_set_level(ROWS[r], 1);
        }
#endif
#if CONFIG_KEYPAD_LOCK_BUTTON_GPIO >= 0
        if (debounce(&lock_btn, gpio_get_level(CONFIG_KEYPAD_LOCK_BUTTON_GPIO) == 0)) {
            keypad_task_post_key(KP_KEY_LOCK);
        }
#endif
#if CONFIG_KEYPAD_PAIR_BUTTON_GPIO >= 0
        debounce(&pair_btn, gpio_get_level(CONFIG_KEYPAD_PAIR_BUTTON_GPIO) == 0);
        if (pair_btn.pressed) {
            pair_held_ms += SCAN_MS;
            if (pair_held_ms >= PAIR_HOLD_MS && !pair_fired) {
                pair_fired = true;
                ESP_LOGI(TAG, "pair button held: pairing");
                keypad_task_post_pair();
            }
        } else {
            pair_held_ms = 0;
            pair_fired = false;
        }
#endif
        vTaskDelay(pdMS_TO_TICKS(SCAN_MS));
    }
}

void input_start(void)
{
    bool any = false;
#if CONFIG_KEYPAD_MATRIX
    for (int r = 0; r < ROW_COUNT; r++) {
        gpio_config_t cfg = {.pin_bit_mask = 1ULL << (unsigned)ROWS[r], .mode = GPIO_MODE_OUTPUT_OD,
                             .pull_up_en = GPIO_PULLUP_ENABLE};
        ESP_ERROR_CHECK(gpio_config(&cfg));
        gpio_set_level(ROWS[r], 1);
    }
    for (int c = 0; c < COL_COUNT; c++) {
        input_pin(COLS[c]);
    }
    any = true;
#endif
#if CONFIG_KEYPAD_LOCK_BUTTON_GPIO >= 0
    input_pin(CONFIG_KEYPAD_LOCK_BUTTON_GPIO);
    any = true;
#endif
#if CONFIG_KEYPAD_PAIR_BUTTON_GPIO >= 0
    input_pin(CONFIG_KEYPAD_PAIR_BUTTON_GPIO);
    any = true;
#endif
    if (!any) {
        ESP_LOGI(TAG, "no input hardware configured; use the console 'keys' command");
        return;
    }
    (void)input_pin;
    xTaskCreate(input_task, "input", INPUT_TASK_STACK, NULL, INPUT_TASK_PRIO, NULL);
}
