carTloyal123/lochness/firmware/apps/lock_unit/main/lock_bridge.h

/*
 * Maps authenticated link requests onto lock_core. Pure C (no ESP-IDF) so the
 * host tests exercise the same code the firmware runs.
 */
#pragma once

#include "lock_core/lc_lock.h"
#include "lock_link/ll.h"

/* Peer roles map to lock_core sources: keypad → KEYPAD (PIN rules apply),
 * phone → APP. REMOTE (remote policy applies) is for Matter, not the link. */
ll_access_result_t lock_bridge_access(lc_t *lc, lp_role_t role, lp_op_t op, const uint8_t *pin,
                                      size_t pin_len);
lp_bolt_t lock_bridge_bolt(const lc_t *lc);

/* LOCK_STATE message for phone sessions: current bolt and door, plus the event that
 * caused it (ev == NULL for a plain snapshot). */
void lock_bridge_state(const lc_t *lc, const lc_event_t *ev, lp_msg_t *out);
