carTloyal123/lochness/firmware/test/host/noise_vectors.h

/* Generated from the cacophony Noise test vectors
 * (https://github.com/haskell-cryptography/cacophony, vectors/cacophony.txt). */
#pragma once
#include <stddef.h>
#include <stdint.h>

typedef struct { const uint8_t *payload; size_t payload_len; const uint8_t *ct; size_t ct_len; } nv_msg_t;
typedef struct { const char *name; const uint8_t *prologue; size_t prologue_len;
  const uint8_t *init_static; const uint8_t *init_ephemeral; const uint8_t *resp_static;
  const uint8_t *resp_ephemeral; const uint8_t *handshake_hash; const nv_msg_t *msgs; size_t msg_count; } nv_vector_t;

static const uint8_t nv_ik_init_prologue[9] = {0x4a,0x6f,0x68,0x6e,0x20,0x47,0x61,0x6c,0x74};
static const uint8_t nv_ik_init_static[32] = {0xe6,0x1e,0xf9,0x91,0x9c,0xde,0x45,0xdd,0x5f,0x82,0x16,0x64,0x04,0xbd,0x08,0xe3,0x8b,0xce,0xb5,0xdf,0xdf,0xde,0xd0,0xa3,0x4c,0x8d,0xf7,0xed,0x54,0x22,0x14,0xd1};
static const uint8_t nv_ik_init_ephemeral[32] = {0x89,0x3e,0x28,0xb9,0xdc,0x6c,0xa8,0xd6,0x11,0xab,0x66,0x47,0x54,0xb8,0xce,0xb7,0xba,0xc5,0x11,0x73,0x49,0xa4,0x43,0x9a,0x6b,0x05,0x69,0xda,0x97,0x7c,0x46,0x4a};
static const uint8_t nv_ik_resp_static[32] = {0x4a,0x3a,0xcb,0xfd,0xb1,0x63,0xde,0xc6,0x51,0xdf,0xa3,0x19,0x4d,0xec,0xe6,0x76,0xd4,0x37,0x02,0x9c,0x62,0xa4,0x08,0xb4,0xc5,0xea,0x91,0x14,0x24,0x6e,0x48,0x93};
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
static const nv_vector_t nv_xx = {"Noise_XX_25519_ChaChaPoly_SHA256", nv_xx_init_prologue, sizeof(nv_xx_init_prologue), nv_xx_init_static, nv_xx_init_ephemeral, nv_xx_resp_static, nv_xx_resp_ephemeral, nv_xx_handshake_hash, nv_xx_msgs, 6};
