carTloyal123/lochness/(commit log)

2026-10-28 Add architecture doc, lock_core, and ESP-IDF lock unit app
    - docs/ARCHITECTURE.md: hub-as-Matter-node topology, wireless keypad,
    US retrofit lock, privacy and security model, milestones
    - lock_core: portable C11 lock logic (users/PINs/schedules, persistent
    exponential-backoff rate limiting, bounded access log, state machine
    with operating modes, auto-relock, jam detection) + 37 host tests
    - platform_esp: NVS persistence, HMAC-SHA256 PIN digests (dev NVS key or
    eFuse HMAC peripheral), wall time, RNG
    - apps/lock_unit: ESP32-C6 app on ESP-IDF v6.0.2 with lock task, door
    sensor, simulated motor and a development console
    - tools/qemu_console.sh: run and script the firmware in QEMU
    Co-A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
    [partitions.csv]
2026-10-28 Add secure lock link and keypad firmware
    The keypad talks to the lock directly over BLE using Noise
    (IK for sessions, XX for pairing). Pairing only works while a
    physical pairing window is open on the lock.
    - secure_link: Noise handshakes and transport encryption. SHA-256
    and HMAC are implemented here; X25519 and ChaCha20-Poly1305 come
    from vendored Monocypher 4.0.2.
    - link_proto: fixed-size frames and messages, plus the BLE UUIDs.
    - lock_link: the lock's side of the link (peers, handshakes,
    request dispatch). keypad_core: the keypad state machine.
    - lock_unit: NimBLE GATT server, plus `pair` and `peers` console
    commands.
    - apps/keypad: new app with a BLE central, button matrix inpu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
    [partitions.csv]
2026-10-28 Fix all clang-tidy findings
    clang-tidy now reports no warnings with every check enabled.
    - Test harness: CHECK/CHECK_EQ call helper functions instead of
    declaring variables inside the macro.
    - Mechanical fixes: direct includes, one declaration per line,
    initialized variables, U literal suffixes.
    - Magic numbers are named constants, and short names are now
    descriptive. Signed bitwise operations use unsigned operands,
    and #define constants are enums.
    - Each ESP module keeps its mutable state in a single static struct
    with one documented lint exemption.
    - Lock console: atoi/sscanf are replaced by checked parsing, so bad
    or out-of-range numbers are rejected instead of becoming 0. Th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
    [ble_central.c, ble_server.c, console.c, door.c, fake_platform.c, fake_platform.h, feedback.c, feedback.h]
2026-11-10 Add Matter hub, bench fixes and strict single-source lint
    Hub (apps/hub, hub_core):
    - Matter door lock over Wi-Fi (esp-matter) that keeps a Noise IK session to
    the lock over BLE; lock/unlock defer to the lock's own decision and the
    lock pushes LOCK_STATE so keypad/knob/auto-relock moves reach Home.
    - Hub pairing in the lock's window, keepalive with TIME_SET (SNTP + TZ).
    - Basic Information provider (Lochness / Lochness Hub, MAC-based serial,
    version 0.1.0), BLE name Lochness-<disc>, `hub commission [min]` to
    reopen the commissioning window from the console.
    - Remote moves without a fabric/node are published as Unspecified instead
    of being rejected (LockState went stale).
    Lock and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
    [partitions.csv]
2026-11-10 Consolidate lint configs and build only the components each app needs
    - Move the ESP-only components (platform_esp, ln_store, ln_central) to
    firmware/apps/components so one apps/.clang-tidy covers all ESP-IDF and
    Matter glue. Three .clang-tidy files remain, each with one job: all rules,
    ESP glue exceptions, vendored Monocypher off. The three duplicate copies
    and the hub-only file are gone.
    - lock_unit and keypad set COMPONENTS main, so they build only what main
    requires. Fixes the QEMU lock build (no Bluetooth), which had tried to
    compile the keypad's BLE central since ln_central became shared.
    - esp.sh: only folders with a CMakeLists.txt are apps.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
2026-11-10 Add esp.sh boards: list plugged-in boards and their app
    Asks each USB serial port's console for help (without resetting the board)
    and names the app from a command only it has. Prints the port, the app and
    the USB bridge's serial number, which follows the board across ports.
    [partitions.csv]
2026-11-10 Remove the Matter hub: the lock becomes the Matter-over-Thread device
    The Wi-Fi hub prototype (apps/hub, hub_core) is retired in favour of a
    hubless design where the lock unit itself is the Matter device on the
    user's Thread network.
    - Delete apps/hub, components/hub_core and the hub_core tests.
    - link_proto: retire role 2 (hub) and PING (0x41); both are rejected and
    never reused, so an old hub pairing can't come back with a new meaning.
    - lock_link: drop the 5-minute hub idle timeout; LOCK_STATE pushes and
    TIME_SET stay for phone sessions (and the coming Matter integration).
    - ln_central: keypad-only now, so it always owns the NimBLE host.
    - Lock console: `pair keypad|phone`; `remote`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
2026-11-10 Make the lock a Matter-over-Thread device, with status LEDs and one lint config
    Matter over Thread on the lock (no hub):
    - Door Lock endpoint in lock_unit (main/matter_lock.cpp): Lock/Unlock become
    lock_core requests from the REMOTE source, so the lock's remote policy and
    modes apply; LockState and operation/alarm events follow the lock task
    through a new state observer.
    - BLE shared with Matter: Matter's BLE manager owns NimBLE and registers the
    link's GATT service; the keypad link advertises on its own extended
    advertising set (legacy PDUs, stable public address), so commissioning and
    the keypad work at once and existing keypad pairings survive.
    - Thread end device (MTD), not a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
    [partitions.csv]
2026-11-10 Document why Apple Home names the lock "Matter Accessory"
    Apple Home takes the default name from the DCL product entry for the
    vendor/product ID, not from the device's Basic Information; the Matter
    test IDs have no entry. Rename in Home until there is a real vendor ID.
2026-11-11 Add hardware CAD: deadbolt fixture and three lock-unit concepts
    hardware/ is a build123d project (uv, Python 3.12) for the lock unit's
    mechanical design:
    - deadbolt/fixture.py: a door with a US single-cylinder deadbolt, the
    interior thumb-turn removed, with presets for door thickness and
    backset. interface() gives the tailpiece, screw posts and bore that
    enclosures design against. Unmeasured values are listed.
    - concepts/: three lock units (A puck, B tall slab, C offset pill)
    built from real parts that attach to each other. They share one drive:
    a back plate on the deadbolt's posts, a coupler on the tailpiece with
    lost-motion in an involute output gear, and an AS5600 encoder. Eac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
    [build_concepts.py, check.py, designs.py, kit.py, test_concepts.py, test_fixture.py]
2026-11-11 Fasten the lock-unit concepts for printing and assembly
    Every screw now threads into a brass heat-set insert, the steel back
    plate's tapped holes, or the motor's own face holes, never bare plastic.
    fix() in concepts/kit.py adds the screw and its insert, cuts the
    clearance, counterbore and insert holes, and picks the shortest stock
    length that engages enough. It sinks the insert deeper when a stock
    length would bottom out.
    - Motors screw to the bridge (A, B) or a bulkhead (C) by their gearbox
    face, with the heads sunk into a bridge that is now 3 mm thick. C's
    strap is gone.
    - The knob and encoder gear are keyed on a D-shaft. The knob screws into
    an insert in the coupler.
    - Covers have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
    [build_concepts.py, check.py, designs.py, kit.py, test_concepts.py]
2026-11-12 Add the dev kit and model every board from its datasheet
    The product and the dev kit now use the same chips. The dev kit has
    them on breakout boards; the product has them on its own PCB.
    - concepts/parts.py models each bought part from its datasheet or
    drawing, coloured part by part, with named pins. The parts are the
    ESP32-C6-MINI-1, the ESP32-C6-DevKitM-1, the DRV8833 and Pololu's
    #2130 carrier for it, the DRV5032 Hall switch on a SOT-23 adapter,
    the TPS629206 and its EVM, the JST SH 6-pin socket, and Pololu's
    micro gearmotor with its encoder.
    - Sensing is the motor's 12 CPR encoder plus three DRV5032 switches:
    bolt locked, bolt unlocked and door. The AS5600 and the DRV8214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
2026-11-12 Add costed BOMs for each assembly and drop the regulator EVM
    bom.py writes one CSV per assembly (A, B, C and the dev kit) to bom/.
    Every modelled part is a line. Parts the model doesn't draw are added
    and marked "not in model":
    - the motor cable, battery leads and hookup wire
    - the door-frame magnet, PCB passives, and the crystal for A's bare
    ESP32
    - for the dev kit: the bare Hall chips, header pins, jumper kit and
    USB-C cable
    Each line has a manufacturer part number, supplier, SKU, unit price
    and link, and says whether its price is confirmed or estimated.
    Printed parts are costed as solid PETG filament. A product PCB is
    priced at the dev boards it replaces, with its chips listed at $0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
    [A-puck.csv, B-slab.csv, C-pill.csv, devkit.csv]
2026-11-12 Add wiring diagrams, main-PCB schematic and an electrical rule check
    One net list (hardware/wiring/netlist.py) now drives three stages:
    - bench: the parts on hand (DevKitM-1, TB6612, A3144s, MP1584 from 2x18650)
    on one 830-point breadboard, drawn to scale in drawings/bench-wiring.svg
    - devkit: the printed rig's breadboards; rig.py derives its wires from the
    net list, drawn in drawings/devkit-wiring.svg
    - product: a KiCad 10 schematic of the main PCB in pcb/main/, checked
    against the net list with KiCad's own net-list export and ERC
    wiring/erc.py checks each stage for driver fights, shorts to ground,
    over/under-voltage, missing pull-ups, missing grounds and strapping-pin
    conflicts, usi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
    [lochness-main.kicad_sch]
2026-11-12 Add a build guide for the bench and dev kit, with the bench on a DevKitC-1
    hardware/SETUP.md covers both builds: pin map, parts, layout and wiring
    diagrams, step-by-step setup, firmware notes and what to check by eye.
    build_wiring.py generates it from the net list, wire plans and BOM, and
    tests check it and the drawings are current.
    - Bench redrawn for the ESP32-C6-DevKitC-1 (16 pins a side, from
    Espressif's user guide); same GPIOs, so the firmware is unchanged.
    - New layout drawings (parts placed, no wires) for both builds, and dev
    kit renders copied into drawings/ by build_devkit.py.
    - A3144 orientation corrected: branded face towards the centre gap.
    - Dev kit BOM: jumper wire rows no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
    [devkit.csv]
2026-11-12 Cap the Matter subscription max interval at 60 s for dev builds
    A controller only learns a subscription died when the lock's next report
    is overdue. Apple Home asks for 600 s, so a subscription lost to Thread
    channel-access failures left Home stuck on "Unlocking" (stale LockState)
    for up to about 10 minutes while the bolt had already moved.
    The lock now lowers the granted max interval to
    CONFIG_LOCHNESS_SUBSCRIPTION_MAX_INTERVAL_S (default 60, 0 = controller's
    choice) through a ReadHandler application callback. It never raises the
    interval, keeps it at or above the controller's min floor, and keeps the
    controller's value if the SDK refuses the change. Subscriptions the lock
    resumes after a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
    [matter_lock.cpp]
